akito914/Four-Leg-BLDC-Driver/quadBLDC.kicad_pcb

## KiCad design quadBLDC.kicad_pcb (2022-10-01)

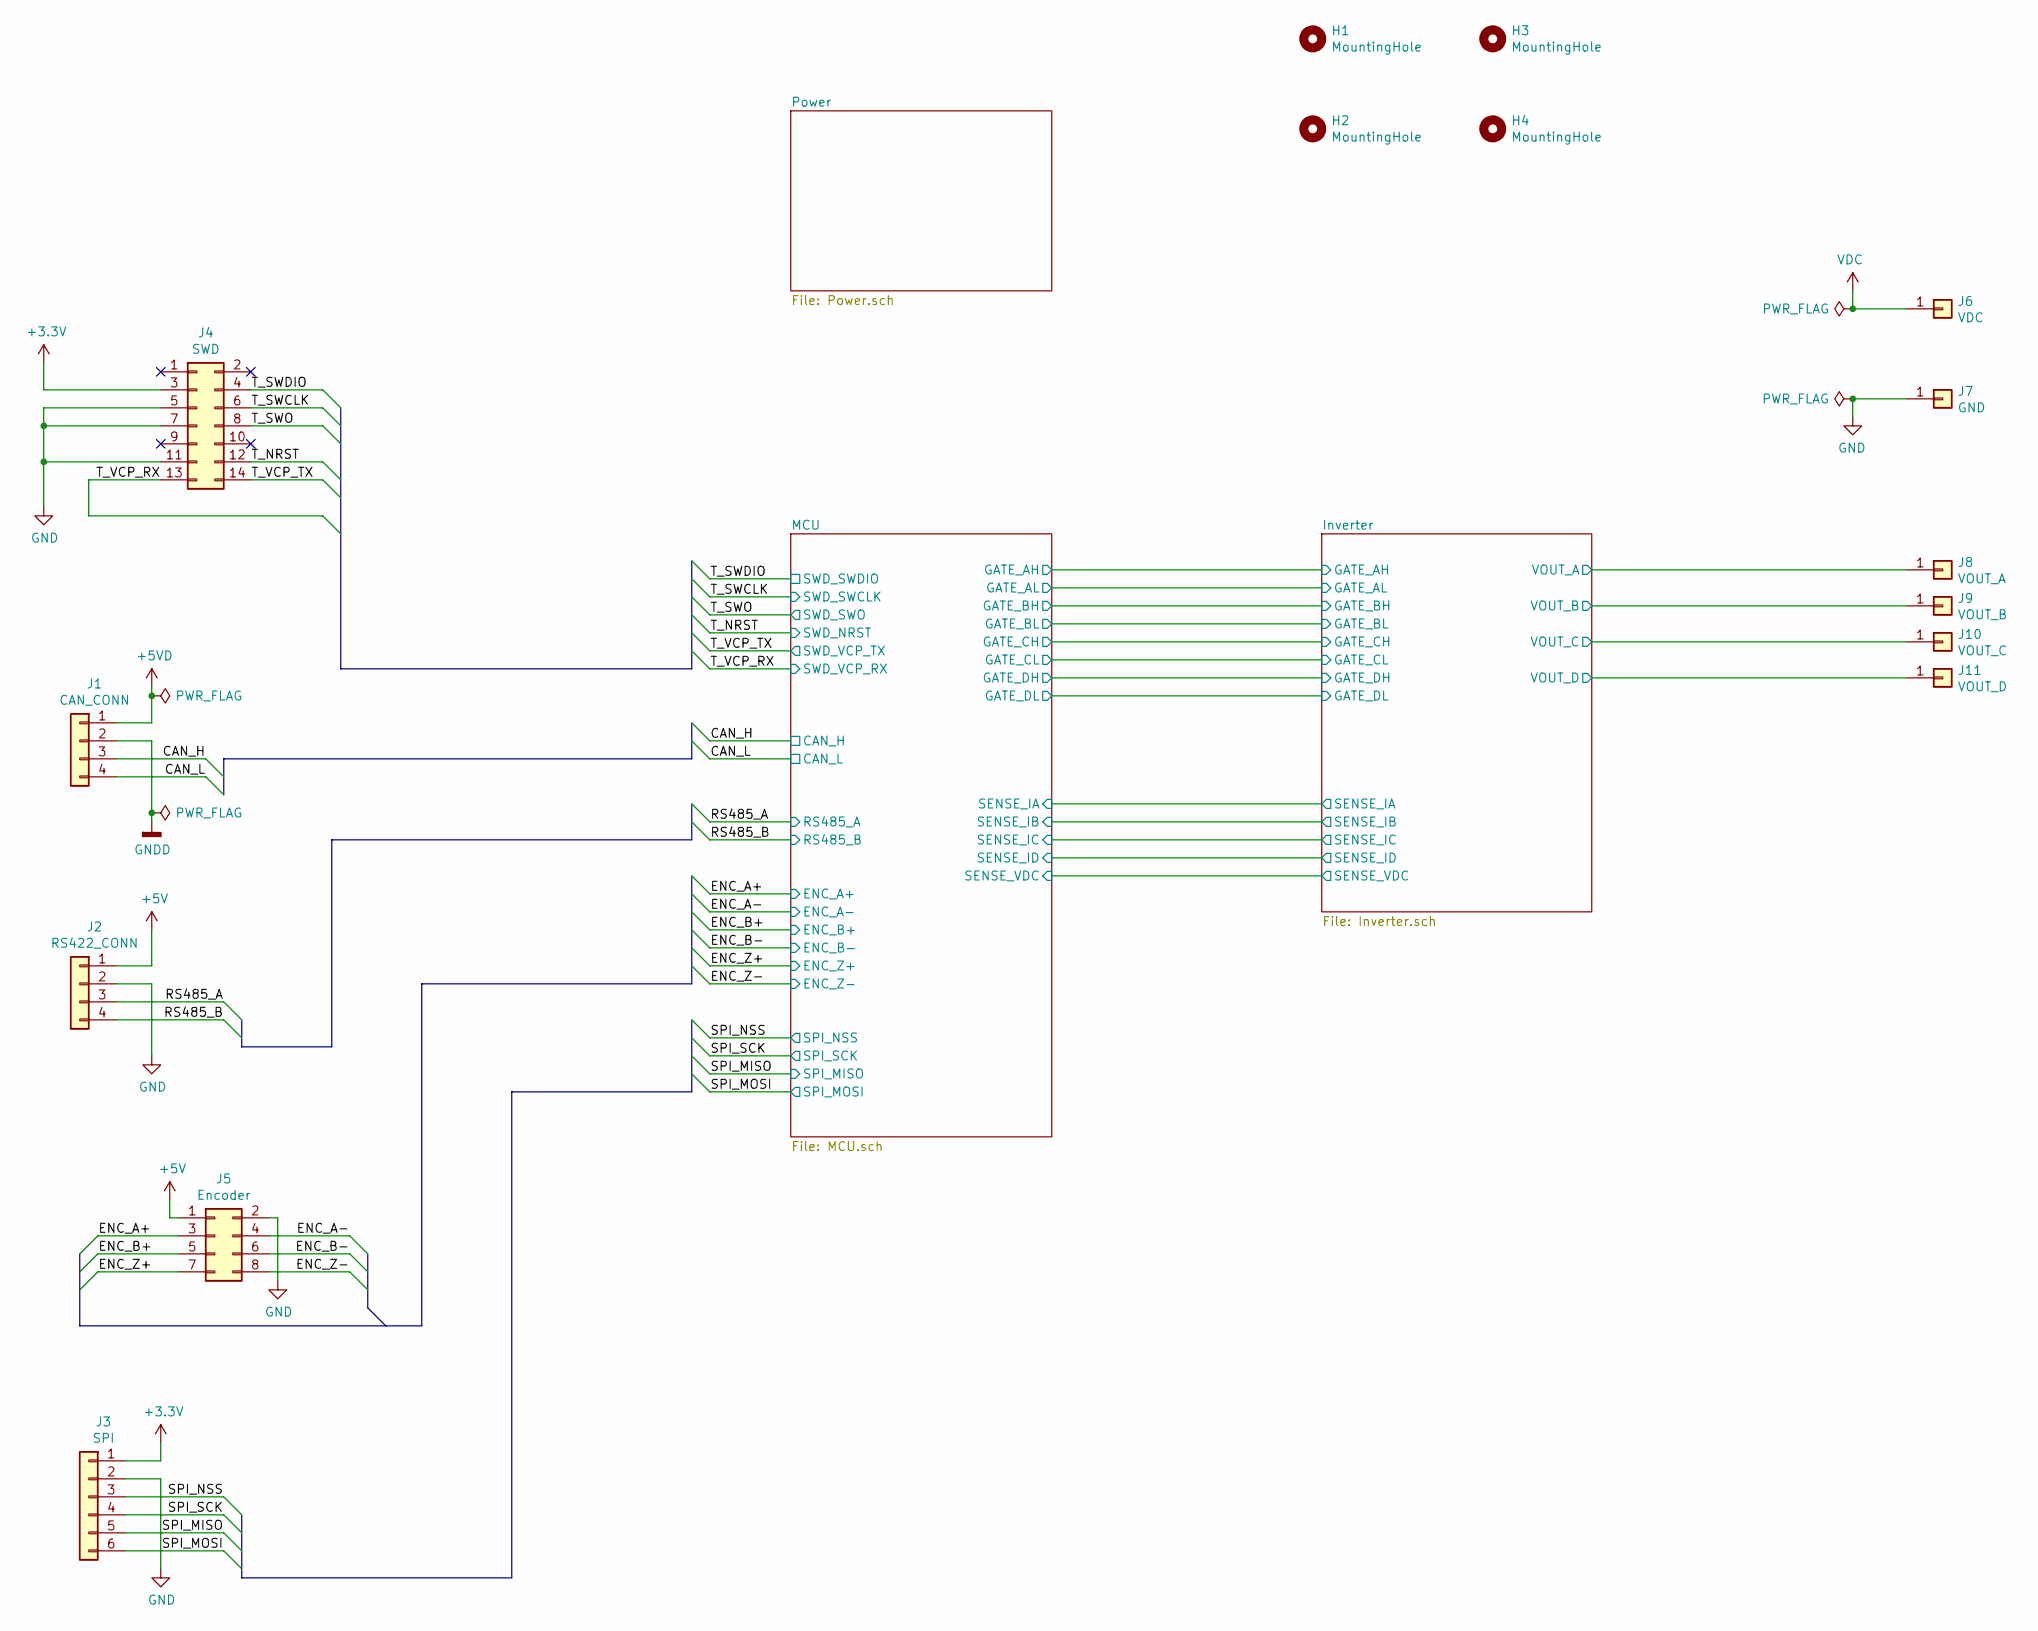
[picture p1: schematic quadBLDC.sch]

Parts:
H1, H2, H3, H4: MountingHole; MountingHole_3.2mm_M3
J1: CAN_CONN; JST_PH_B4B-PH-K_1x04_P2.00mm_Vertical
J2: RS422_CONN; JST_PH_B4B-PH-K_1x04_P2.00mm_Vertical
J3: SPI; JST_PH_B6B-PH-K_1x06_P2.00mm_Vertical
J4: SWD; PinHeader_2x07_P1.27mm_Vertical_SMD
J5: Encoder; JST_PHD_B8B-PHDSS_2x04_P2.00mm_Vertical
J6: VDC; SolderWire-2.5sqmm_1x01_D2.4mm_OD3.6mm
J7: GND; SolderWire-2.5sqmm_1x01_D2.4mm_OD3.6mm
J8: VOUT_A; SolderWire-2.5sqmm_1x01_D2.4mm_OD3.6mm
J9: VOUT_B; SolderWire-2.5sqmm_1x01_D2.4mm_OD3.6mm
J10: VOUT_C; SolderWire-2.5sqmm_1x01_D2.4mm_OD3.6mm
J11: VOUT_D; SolderWire-2.5sqmm_1x01_D2.4mm_OD3.6mm

Connections:
+3V3: J3.1, J4.3; also elsewhere on the board
+5V: J2.1, J5.1; also elsewhere on the board
+5VD: J1.1; also elsewhere on the board
/CAN_H: J1.3; also elsewhere on the board
/CAN_L: J1.4; also elsewhere on the board
/ENC_A+: J5.3; also elsewhere on the board
/ENC_A-: J5.4; also elsewhere on the board
/ENC_B+: J5.5; also elsewhere on the board
/ENC_B-: J5.6; also elsewhere on the board
/ENC_Z+: J5.7; also elsewhere on the board
/ENC_Z-: J5.8; also elsewhere on the board
/Inverter/VOUT_A: J8.1; also elsewhere on the board
/Inverter/VOUT_B: J9.1; also elsewhere on the board
/Inverter/VOUT_C: J10.1; also elsewhere on the board
/Inverter/VOUT_D: J11.1; also elsewhere on the board
/RS485_A: J2.3; also elsewhere on the board
/RS485_B: J2.4; also elsewhere on the board
/SPI_MISO: J3.5; also elsewhere on the board
/SPI_MOSI: J3.6; also elsewhere on the board
/SPI_NSS: J3.3; also elsewhere on the board
/SPI_SCK: J3.4; also elsewhere on the board
/T_NRST: J4.12; also elsewhere on the board
/T_SWCLK: J4.6; also elsewhere on the board
/T_SWDIO: J4.4; also elsewhere on the board
/T_SWO: J4.8; also elsewhere on the board
/T_VCP_RX: J4.13; also elsewhere on the board
/T_VCP_TX: J4.14; also elsewhere on the board
GND: J2.2, J3.2, J4.5, J4.7, J4.11, J5.2, J7.1; also elsewhere on the board
GNDD: J1.2; also elsewhere on the board
VDC: J6.1; also elsewhere on the board

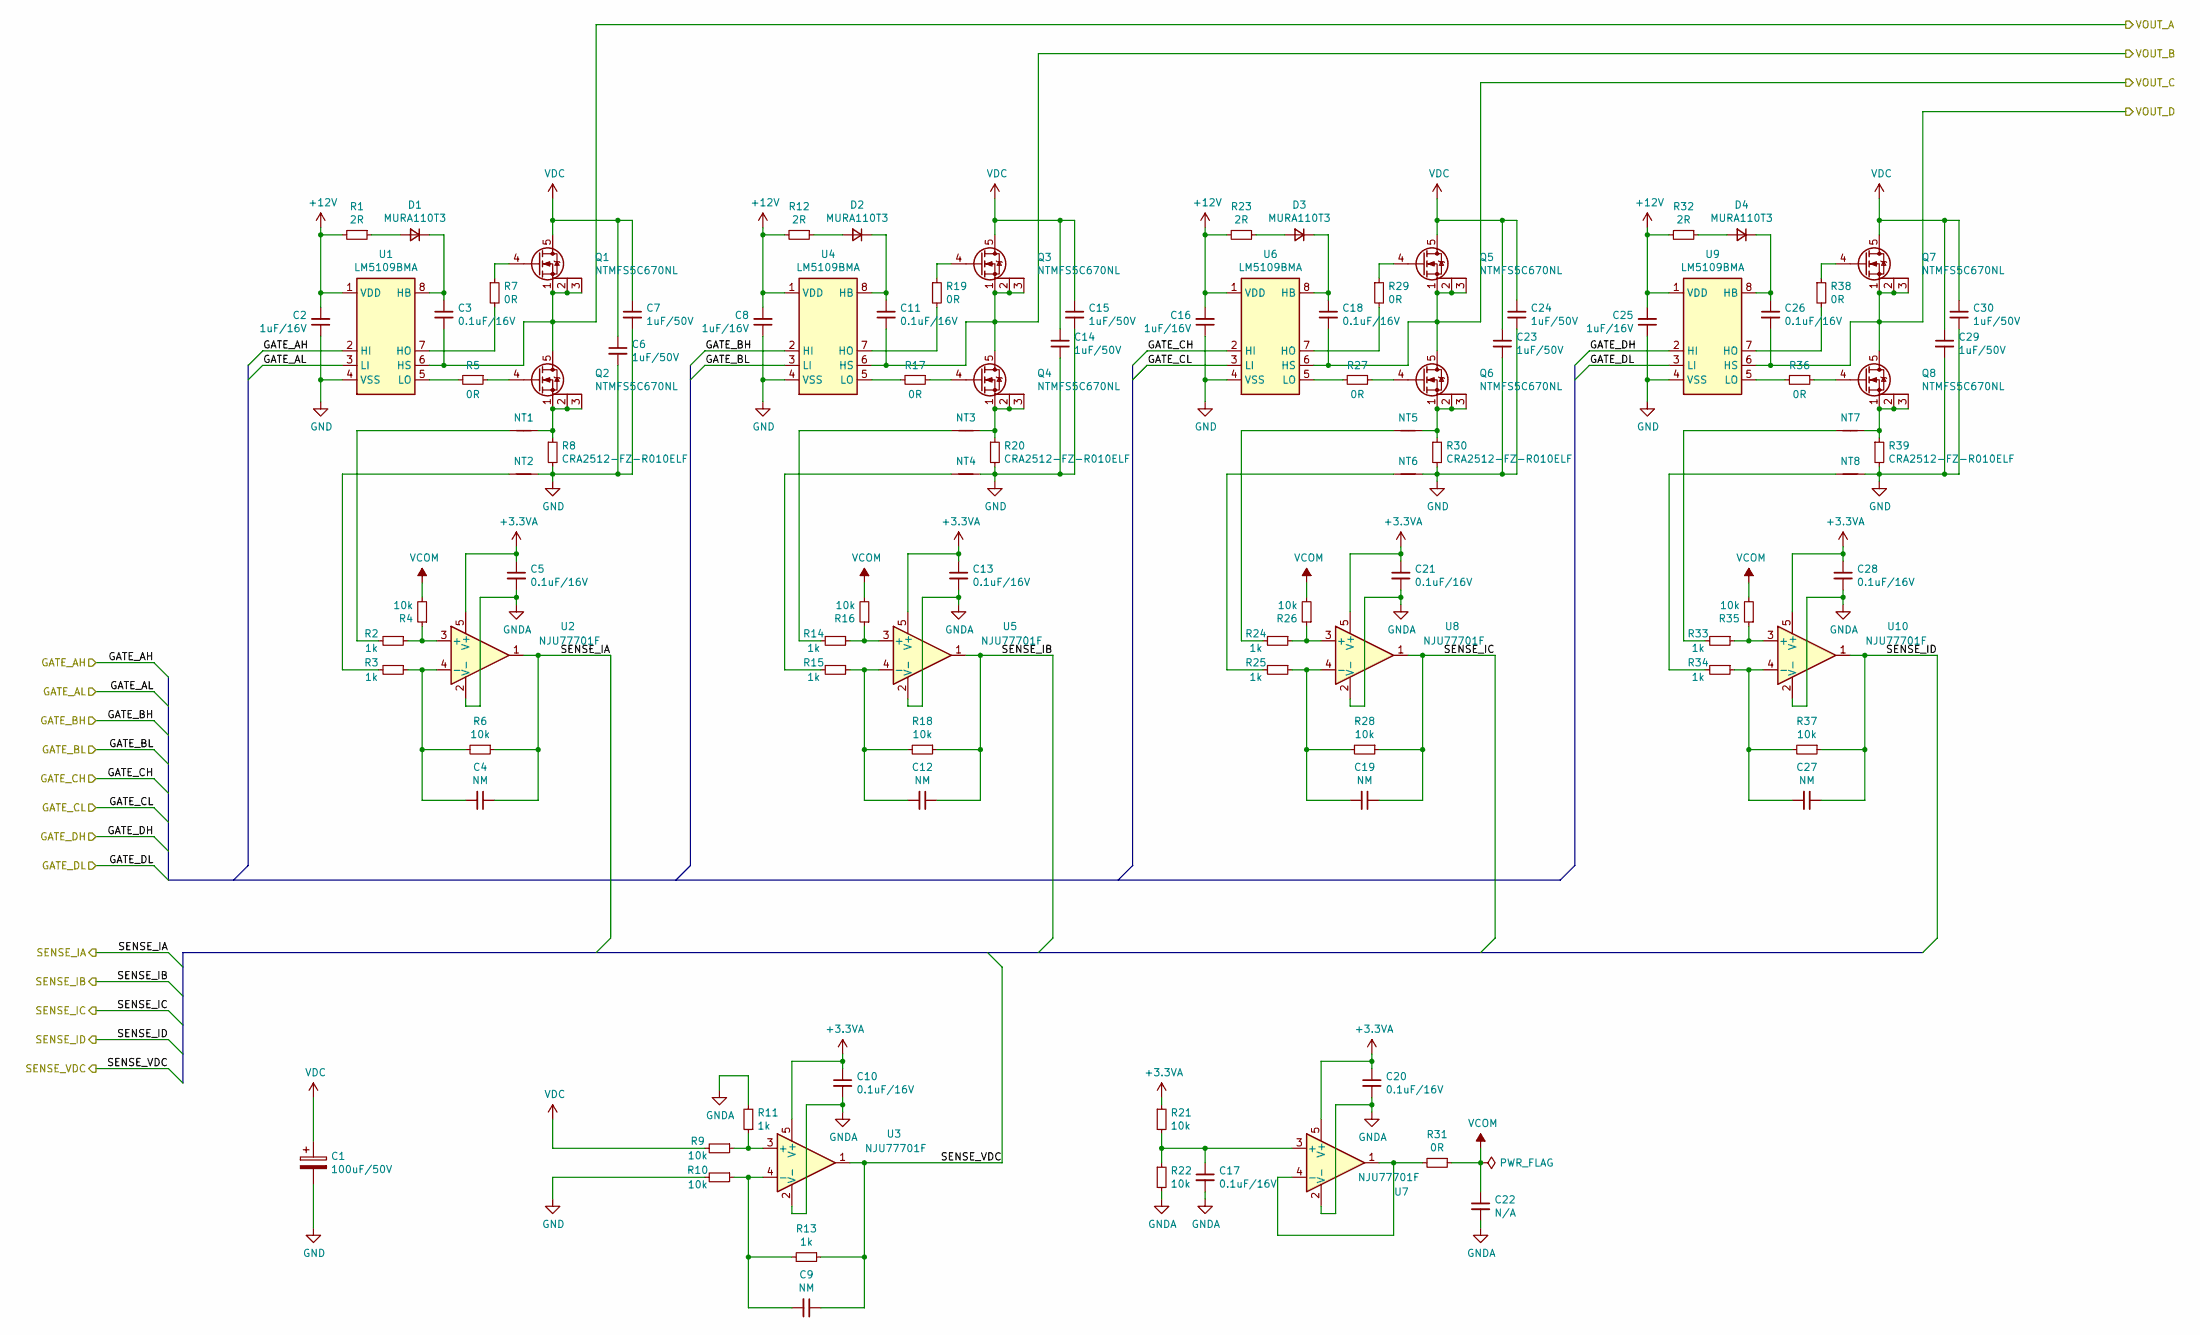
[picture p2: schematic Inverter.sch]

Parts:
C1: 100uF/50V; CP_Elec_10x10
C2, C8, C16, C25: 1uF/16V; C_0603_1608Metric
C3, C5, C10, C11, C13, C17, C18, C20, C21, C26, C28: 0.1uF/16V; C_0603_1608Metric
C4, C9, C12, C19, C27: NM; C_0603_1608Metric
C6, C7, C14, C15, C23, C24, C29, C30: 1uF/50V; C_0805_2012Metric
C22: N/A; C_0603_1608Metric
D1, D2, D3, D4: MURA110T3; D_SMA
NT1, NT2, NT3, NT4, NT5, NT6, NT7, NT8: Net-Tie_2; NetTie-2_SMD_Pad0.5mm
Q1, Q2, Q3, Q4, Q5, Q6, Q7, Q8: NTMFS5C670NL; PowerPAK_SO-8_Single
R1, R12, R23, R32: 2R; R_0603_1608Metric
R2, R3, R11, R13, R14, R15, R24, R25, R33, R34: 1k; R_0603_1608Metric
R4, R6, R9, R10, R16, R18, R21, R22, R26, R28, R35, R37: 10k; R_0603_1608Metric
R5, R7, R17, R19, R27, R29, R31, R36, R38: 0R; R_0603_1608Metric
R8, R20, R30, R39: CRA2512-FZ-R010ELF; R_2512_6332Metric
U1, U4, U6, U9: LM5109BMA; SOIC-8_3.9x4.9mm_P1.27mm
U2, U3, U5, U7, U8, U10: NJU77701F; SOT-23-5

Connections:
+3.3VA: C5.1, C10.1, C13.1, C20.1, C21.1, C28.1, R21.1, U2.5 (V+), U3.5 (V+), U5.5 (V+), U7.5 (V+), U8.5 (V+), U10.5 (V+); also elsewhere on the board
+12V: C2.2, C8.2, C16.2, C25.2, R1.2, R12.2, R23.2, R32.2, U1.1 (VDD), U4.1 (VDD), U6.1 (VDD), U9.1 (VDD); also elsewhere on the board
/Inverter/GATE_AH: U1.2 (HI); also elsewhere on the board
/Inverter/GATE_AL: U1.3 (LI); also elsewhere on the board
/Inverter/GATE_BH: U4.2 (HI); also elsewhere on the board
/Inverter/GATE_BL: U4.3 (LI); also elsewhere on the board
/Inverter/GATE_CH: U6.2 (HI); also elsewhere on the board
/Inverter/GATE_CL: U6.3 (LI); also elsewhere on the board
/Inverter/GATE_DH: U9.2 (HI); also elsewhere on the board
/Inverter/GATE_DL: U9.3 (LI); also elsewhere on the board
/Inverter/SENSE_IA: C4.1, R6.1, U2.1; also elsewhere on the board
/Inverter/SENSE_IB: C12.1, R18.1, U5.1; also elsewhere on the board
/Inverter/SENSE_IC: C19.1, R28.1, U8.1; also elsewhere on the board
/Inverter/SENSE_ID: C27.1, R37.1, U10.1; also elsewhere on the board
/Inverter/SENSE_VDC: C9.1, R13.1, U3.1; also elsewhere on the board
/Inverter/VOUT_A: C3.2, Q1.1 (S), Q1.2 (D), Q1.3 (D), Q2.5 (D), U1.6 (HS); also elsewhere on the board
/Inverter/VOUT_B: C11.2, Q3.1 (S), Q3.2 (D), Q3.3 (D), Q4.5 (D), U4.6 (HS); also elsewhere on the board
/Inverter/VOUT_C: C18.2, Q5.1 (S), Q5.2 (D), Q5.3 (D), Q6.5 (D), U6.6 (HS); also elsewhere on the board
/Inverter/VOUT_D: C26.2, Q7.1 (S), Q7.2 (D), Q7.3 (D), Q8.5 (D), U9.6 (HS); also elsewhere on the board
GND: C1.2, C2.1, C6.2, C7.2, C8.1, C14.2, C15.2, C16.1, C23.2, C24.2, C25.1, C29.2, C30.2, NT2.1, NT4.1, NT6.1, NT8.1, R8.2, R10.2, R20.2, R30.2, R39.2, U1.4 (VSS), U4.4 (VSS), U6.4 (VSS), U9.4 (VSS); also elsewhere on the board
GNDA: C5.2, C10.2, C13.2, C17.2, C20.2, C21.2, C22.2, C28.2, R11.2, R22.2, U2.2 (V-), U3.2 (V-), U5.2 (V-), U7.2 (V-), U8.2 (V-), U10.2 (V-); also elsewhere on the board
unnamed: C3.1, D1.1 (K), U1.8 (HB)
unnamed: C4.2, R3.1, R6.2, U2.4 (-)
unnamed: C9.2, R10.1, R13.2, U3.4 (-)
unnamed: C11.1, D2.1 (K), U4.8 (HB)
unnamed: C12.2, R15.1, R18.2, U5.4 (-)
unnamed: C17.1, R21.2, R22.1, U7.3 (+)
unnamed: C18.1, D3.1 (K), U6.8 (HB)
unnamed: C19.2, R25.1, R28.2, U8.4 (-)
unnamed: C26.1, D4.1 (K), U9.8 (HB)
unnamed: C27.2, R34.1, R37.2, U10.4 (-)
unnamed: D1.2 (A), R1.1
unnamed: D2.2 (A), R12.1
unnamed: D3.2 (A), R23.1
unnamed: D4.2 (A), R32.1
unnamed: NT1.1, Q2.1 (S), Q2.2 (D), Q2.3 (D), R8.1
unnamed: NT1.2, R2.2
unnamed: NT2.2, R3.2
unnamed: NT3.1, Q4.1 (S), Q4.2 (D), Q4.3 (D), R20.1
unnamed: NT3.2, R14.2
unnamed: NT4.2, R15.2
unnamed: NT5.1, Q6.1 (S), Q6.2 (D), Q6.3 (D), R30.1
unnamed: NT5.2, R24.2
unnamed: NT6.2, R25.2
unnamed: NT7.1, Q8.1 (S), Q8.2 (D), Q8.3 (D), R39.1
unnamed: NT7.2, R33.2
unnamed: NT8.2, R34.2
unnamed: Q1.4 (G), R7.1
unnamed: Q2.4 (G), R5.1
unnamed: Q3.4 (G), R19.1
unnamed: Q4.4 (G), R17.1
unnamed: Q5.4 (G), R29.1
unnamed: Q6.4 (G), R27.1
unnamed: Q7.4 (G), R38.1
unnamed: Q8.4 (G), R36.1
unnamed: R2.1, R4.1, U2.3 (+)
unnamed: R5.2, U1.5 (LO)
unnamed: R7.2, U1.7 (HO)
unnamed: R9.1, R11.1, U3.3 (+)
unnamed: R14.1, R16.1, U5.3 (+)
unnamed: R17.2, U4.5 (LO)
unnamed: R19.2, U4.7 (HO)
unnamed: R24.1, R26.1, U8.3 (+)
unnamed: R27.2, U6.5 (LO)
unnamed: R29.2, U6.7 (HO)
unnamed: R31.2, U7.1, U7.4 (-)
unnamed: R33.1, R35.1, U10.3 (+)
unnamed: R36.2, U9.5 (LO)
unnamed: R38.2, U9.7 (HO)
VCOM: C22.1, R4.2, R16.2, R26.2, R31.1, R35.2
VDC: C1.1, C6.1, C7.1, C14.1, C15.1, C23.1, C24.1, C29.1, C30.1, Q1.5 (D), Q3.5 (D), Q5.5 (D), Q7.5 (D), R9.2; also elsewhere on the board

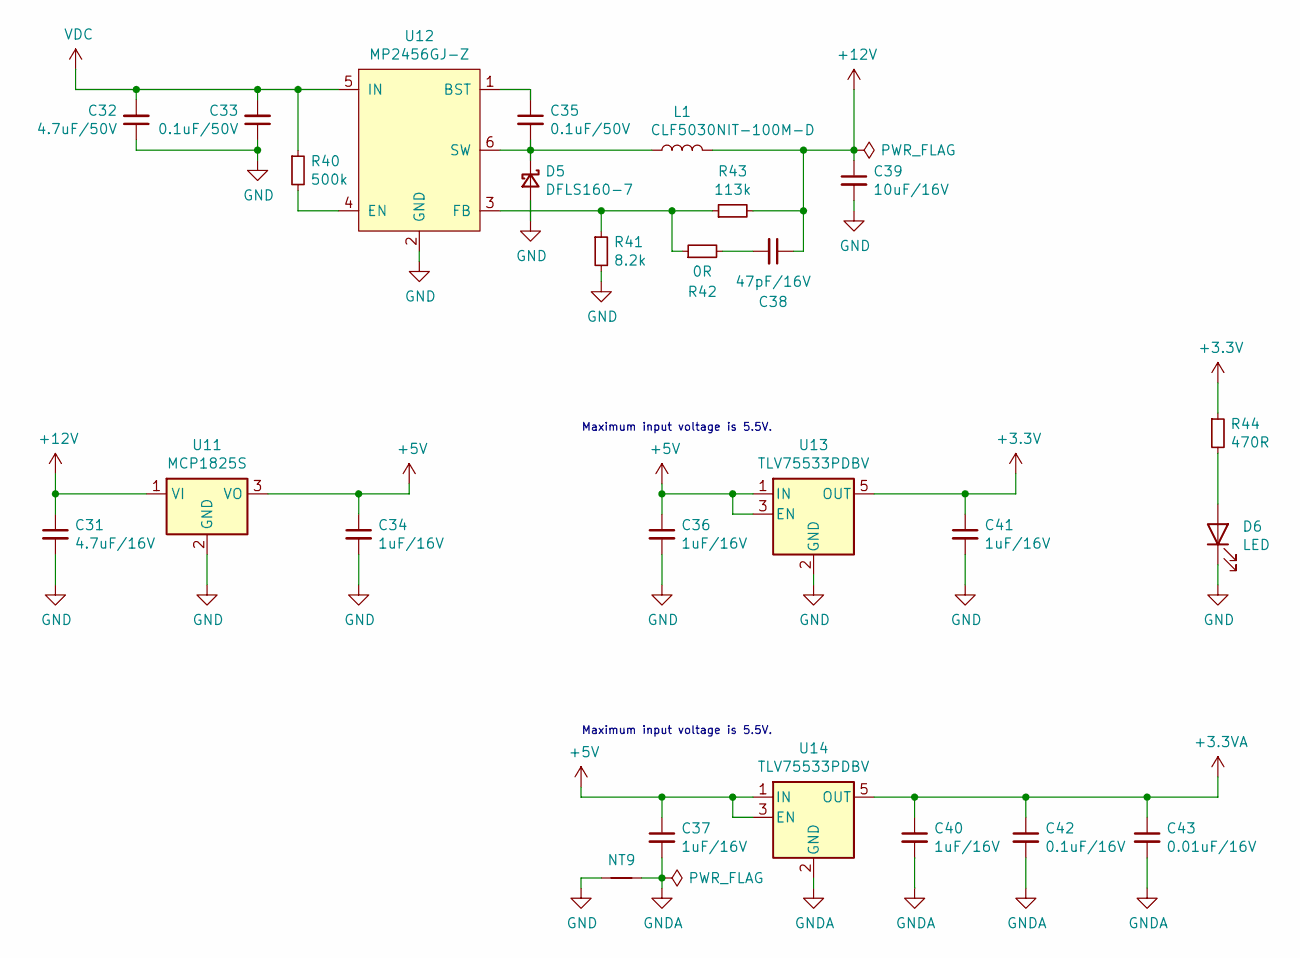
[picture p3: schematic Power.sch]

Parts:
C31: 4.7uF/16V; C_0805_2012Metric
C32: 4.7uF/50V; C_0805_2012Metric
C33, C35: 0.1uF/50V; C_0603_1608Metric
C34, C36, C37, C40, C41: 1uF/16V; C_0603_1608Metric
C38: 47pF/16V; C_0603_1608Metric
C39: 10uF/16V; C_0805_2012Metric
C42: 0.1uF/16V; C_0603_1608Metric
C43: 0.01uF/16V; C_0603_1608Metric
D5: DFLS160-7; D_PowerDI-123
D6: LED; LED_0603_1608Metric
L1: CLF5030NIT-100M-D; L_TDK_CLF5030NI-D
NT9: Net-Tie_2; NetTie-2_SMD_Pad0.5mm
R40: 500k; R_0603_1608Metric
R41: 8.2k; R_0603_1608Metric
R42: 0R; R_0603_1608Metric
R43: 113k; R_0603_1608Metric
R44: 470R; R_0603_1608Metric
U11: MCP1825S; SOT-223-3_TabPin2
U12: MP2456GJ-Z; SOT-23-6
U13, U14: TLV75533PDBV; SOT-23-5

Connections:
+3.3VA: C40.1, C42.1, C43.1, U14.5 (OUT); also elsewhere on the board
+3V3: C41.1, R44.1, U13.5 (OUT); also elsewhere on the board
+5V: C34.1, C36.1, C37.1, U11.3 (VO), U13.1 (IN), U13.3 (EN), U14.1 (IN), U14.3 (EN); also elsewhere on the board
+12V: C31.1, C38.1, C39.1, L1.2, R43.2, U11.1 (VI); also elsewhere on the board
GND: C31.2, C32.1, C33.1, C34.2, C36.2, C39.2, C41.2, D5.2 (A), D6.1 (K), NT9.2, R41.2, U11.2 (GND), U12.2 (GND), U13.2 (GND); also elsewhere on the board
GNDA: C37.2, C40.2, C42.2, C43.2, NT9.1, U14.2 (GND); also elsewhere on the board
unnamed: C35.1, U12.1 (BST)
unnamed: C35.2, D5.1 (K), L1.1, U12.6 (SW)
unnamed: C38.2, R42.2
unnamed: D6.2 (A), R44.2
unnamed: R40.2, U12.4 (EN)
unnamed: R41.1, R42.1, R43.1, U12.3 (FB)
VDC: C32.2, C33.2, R40.1, U12.5 (IN); also elsewhere on the board

Notes on the sheet:
Maximum input voltage is 5.5V.

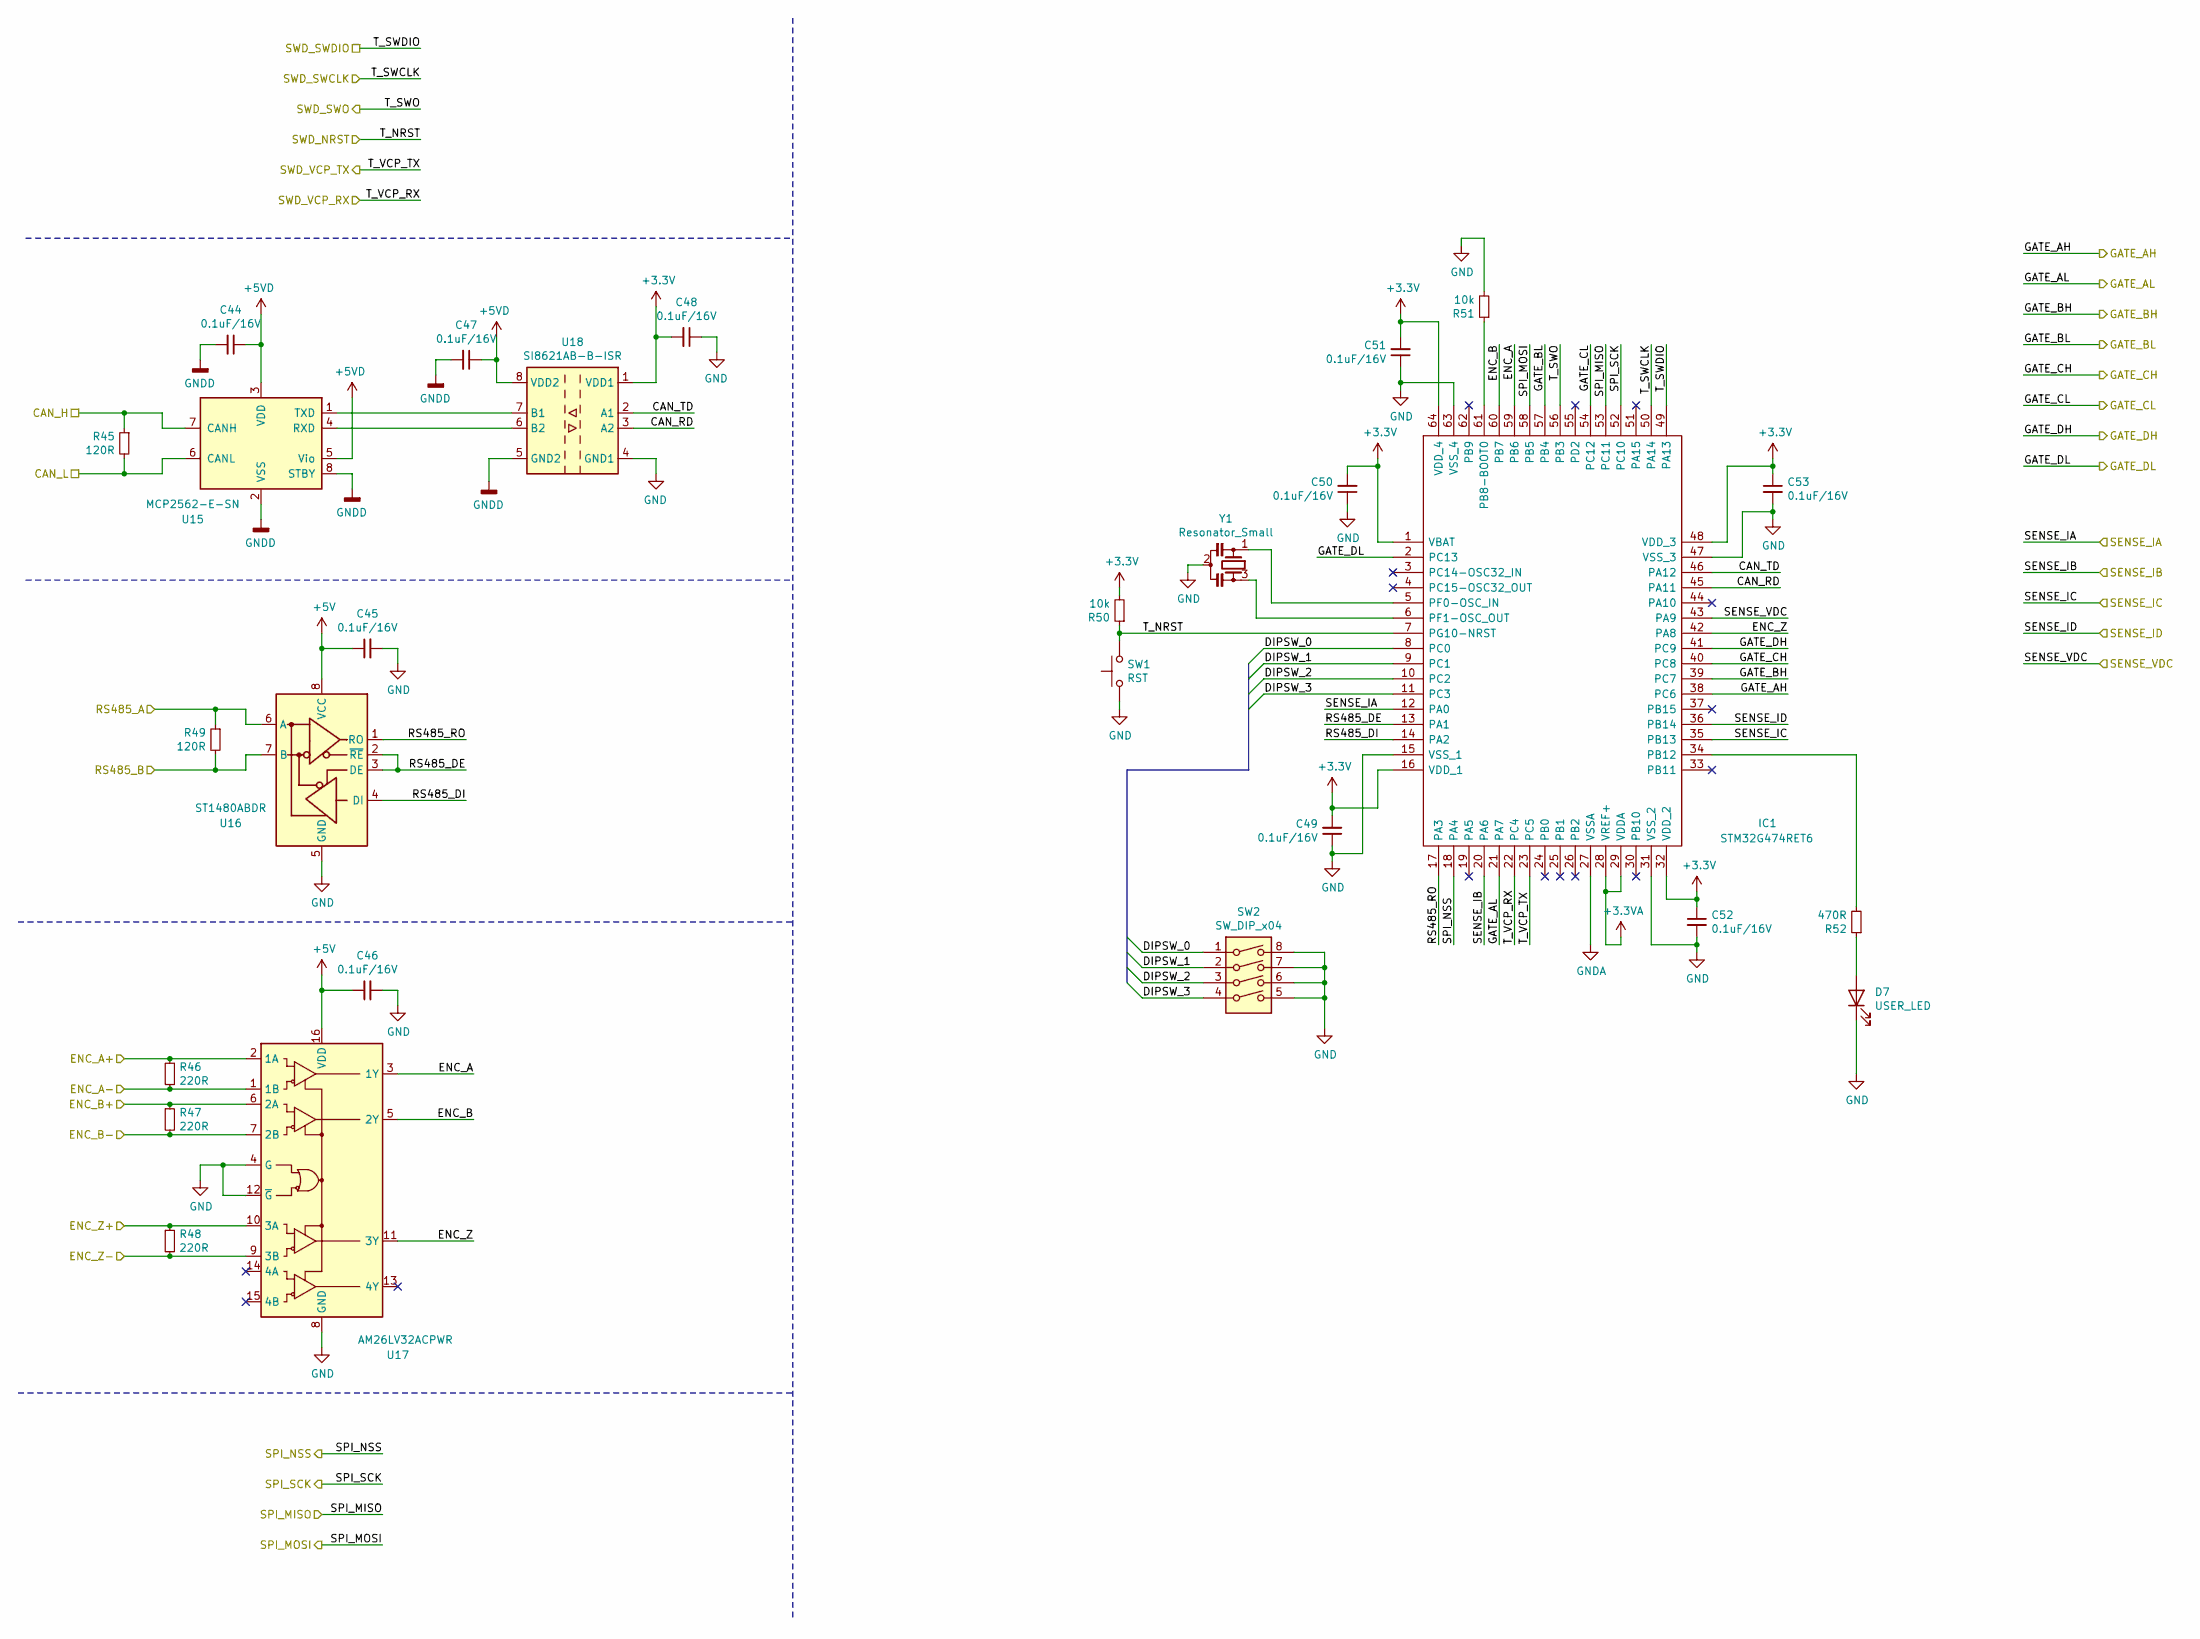
[picture p4: schematic MCU.sch]

Parts:
C44, C45, C46, C47, C48, C49, C50, C51, C52, C53: 0.1uF/16V; C_0603_1608Metric
D7: USER_LED; LED_0603_1608Metric
IC1: STM32G474RET6; QFP50P1200X1200X160-64N
R45, R49: 120R; R_0603_1608Metric
R46, R47, R48: 220R; R_0603_1608Metric
R50, R51: 10k; R_0603_1608Metric
R52: 470R; R_0603_1608Metric
SW1: RST; SKRPACE010
SW2: SW_DIP_x04; SOIC127P812X230-8N
U15: MCP2562-E-SN; SOIC-8_3.9x4.9mm_P1.27mm
U16: ST1480ABDR; SOIC-8_3.9x4.9mm_P1.27mm
U17: AM26LV32ACPWR; TSSOP-16_4.4x5mm_P0.65mm
U18: SI8621AB-B-ISR; SOIC-8_3.9x4.9mm_P1.27mm
Y1: Resonator_Small; Resonator_SMD_muRata_CSTxExxV-3Pin_3.0x1.1mm

Connections:
+3.3VA: IC1.28 (VREF+), IC1.29 (VDDA); also elsewhere on the board
+3V3: C48.2, C49.2, C50.2, C51.2, C52.1, C53.1, IC1.1 (VBAT), IC1.16 (VDD_1), IC1.32 (VDD_2), IC1.48 (VDD_3), IC1.64 (VDD_4), R50.2, U18.1 (VDD1); also elsewhere on the board
+5V: C45.1, C46.1, U16.8 (VCC), U17.16 (VDD); also elsewhere on the board
+5VD: C44.1, C47.1, U15.3 (VDD), U15.5 (Vio), U18.8 (VDD2); also elsewhere on the board
/CAN_H: R45.1, U15.7 (CANH); also elsewhere on the board
/CAN_L: R45.2, U15.6 (CANL); also elsewhere on the board
/ENC_A+: R46.1, U17.2 (1A); also elsewhere on the board
/ENC_A-: R46.2, U17.1 (1B); also elsewhere on the board
/ENC_B+: R47.1, U17.6 (2A); also elsewhere on the board
/ENC_B-: R47.2, U17.7 (2B); also elsewhere on the board
/ENC_Z+: R48.1, U17.10 (3A); also elsewhere on the board
/ENC_Z-: R48.2, U17.9 (3B); also elsewhere on the board
/Inverter/GATE_AH: IC1.38 (PC6); also elsewhere on the board
/Inverter/GATE_AL: IC1.21 (PA7); also elsewhere on the board
/Inverter/GATE_BH: IC1.39 (PC7); also elsewhere on the board
/Inverter/GATE_BL: IC1.57 (PB4); also elsewhere on the board
/Inverter/GATE_CH: IC1.40 (PC8); also elsewhere on the board
/Inverter/GATE_CL: IC1.54 (PC12); also elsewhere on the board
/Inverter/GATE_DH: IC1.41 (PC9); also elsewhere on the board
/Inverter/GATE_DL: IC1.2 (PC13); also elsewhere on the board
/Inverter/SENSE_IA: IC1.12 (PA0); also elsewhere on the board
/Inverter/SENSE_IB: IC1.20 (PA6); also elsewhere on the board
/Inverter/SENSE_IC: IC1.35 (PB13); also elsewhere on the board
/Inverter/SENSE_ID: IC1.36 (PB14); also elsewhere on the board
/Inverter/SENSE_VDC: IC1.43 (PA9); also elsewhere on the board
/MCU/CAN_RD: IC1.45 (PA11), U18.3 (A2)
/MCU/CAN_TD: IC1.46 (PA12), U18.2 (A1)
/MCU/DIPSW_0: IC1.8 (PC0), SW2.1
/MCU/DIPSW_1: IC1.9 (PC1), SW2.2
/MCU/DIPSW_2: IC1.10 (PC2), SW2.3
/MCU/DIPSW_3: IC1.11 (PC3), SW2.4
/MCU/ENC_A: IC1.59 (PB6), U17.3 (1Y)
/MCU/ENC_B: IC1.60 (PB7), U17.5 (2Y)
/MCU/ENC_Z: IC1.42 (PA8), U17.11 (3Y)
/MCU/RS485_DE: IC1.13 (PA1), U16.2 (~RE), U16.3 (DE)
/MCU/RS485_DI: IC1.14 (PA2), U16.4 (DI)
/MCU/RS485_RO: IC1.17 (PA3), U16.1 (RO)
/RS485_A: R49.1, U16.6 (A); also elsewhere on the board
/RS485_B: R49.2, U16.7 (B); also elsewhere on the board
/SPI_MISO: IC1.53 (PC11); also elsewhere on the board
/SPI_MOSI: IC1.58 (PB5); also elsewhere on the board
/SPI_NSS: IC1.18 (PA4); also elsewhere on the board
/SPI_SCK: IC1.52 (PC10); also elsewhere on the board
/T_NRST: IC1.7 (PG10-NRST), R50.1, SW1.2; also elsewhere on the board
/T_SWCLK: IC1.50 (PA14); also elsewhere on the board
/T_SWDIO: IC1.49 (PA13); also elsewhere on the board
/T_SWO: IC1.56 (PB3); also elsewhere on the board
/T_VCP_RX: IC1.22 (PC4); also elsewhere on the board
/T_VCP_TX: IC1.23 (PC5); also elsewhere on the board
GND: C45.2, C46.2, C48.1, C49.1, C50.1, C51.1, C52.2, C53.2, D7.1 (K), IC1.15 (VSS_1), IC1.31 (VSS_2), IC1.47 (VSS_3), IC1.63 (VSS_4), R51.2, SW1.1, SW2.5, SW2.6, SW2.7, SW2.8, U16.5 (GND), U17.4 (G), U17.8 (GND), U17.12 (~G), U18.4 (GND1), Y1.2; also elsewhere on the board
GNDA: IC1.27 (VSSA); also elsewhere on the board
GNDD: C44.2, C47.2, U15.2 (VSS), U15.8 (STBY), U18.5 (GND2); also elsewhere on the board
unnamed: D7.2 (A), R52.1
unnamed: IC1.5 (PF0-OSC_IN), Y1.1
unnamed: IC1.6 (PF1-OSC_OUT), Y1.3
unnamed: IC1.34 (PB12), R52.2
unnamed: IC1.61 (PB8-BOOT0), R51.1
unnamed: U15.1 (TXD), U18.7 (B1)
unnamed: U15.4 (RXD), U18.6 (B2)

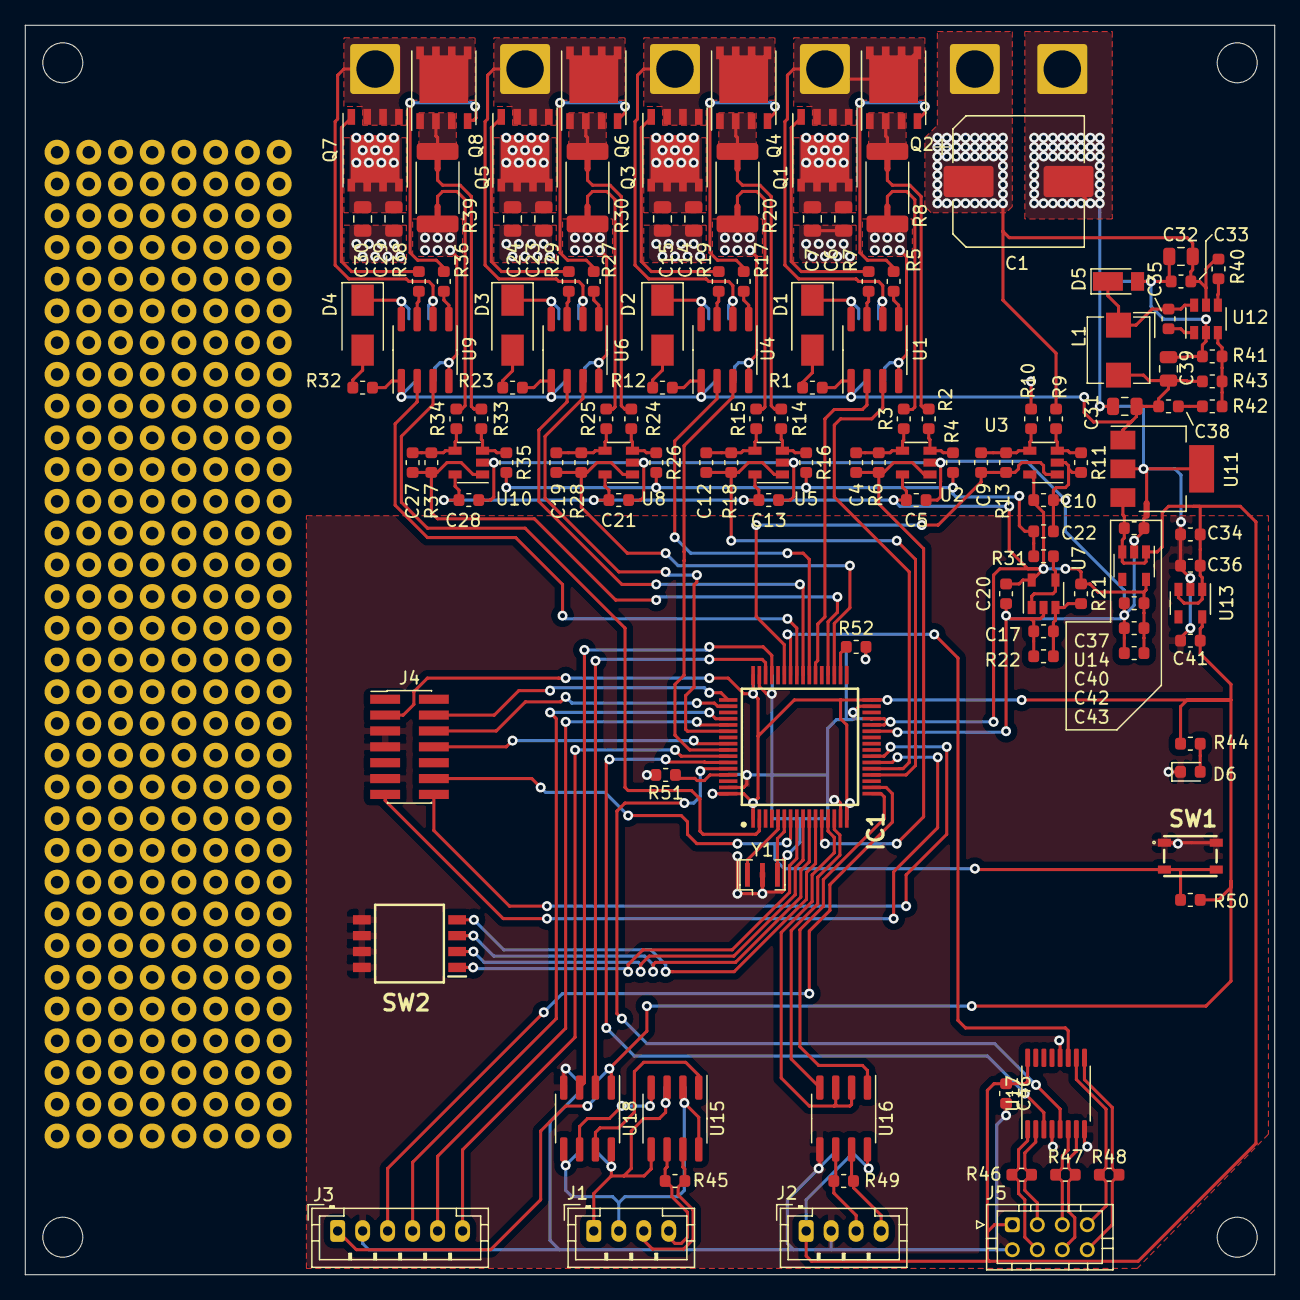
[picture p5: board quadBLDC.kicad_pcb from above]

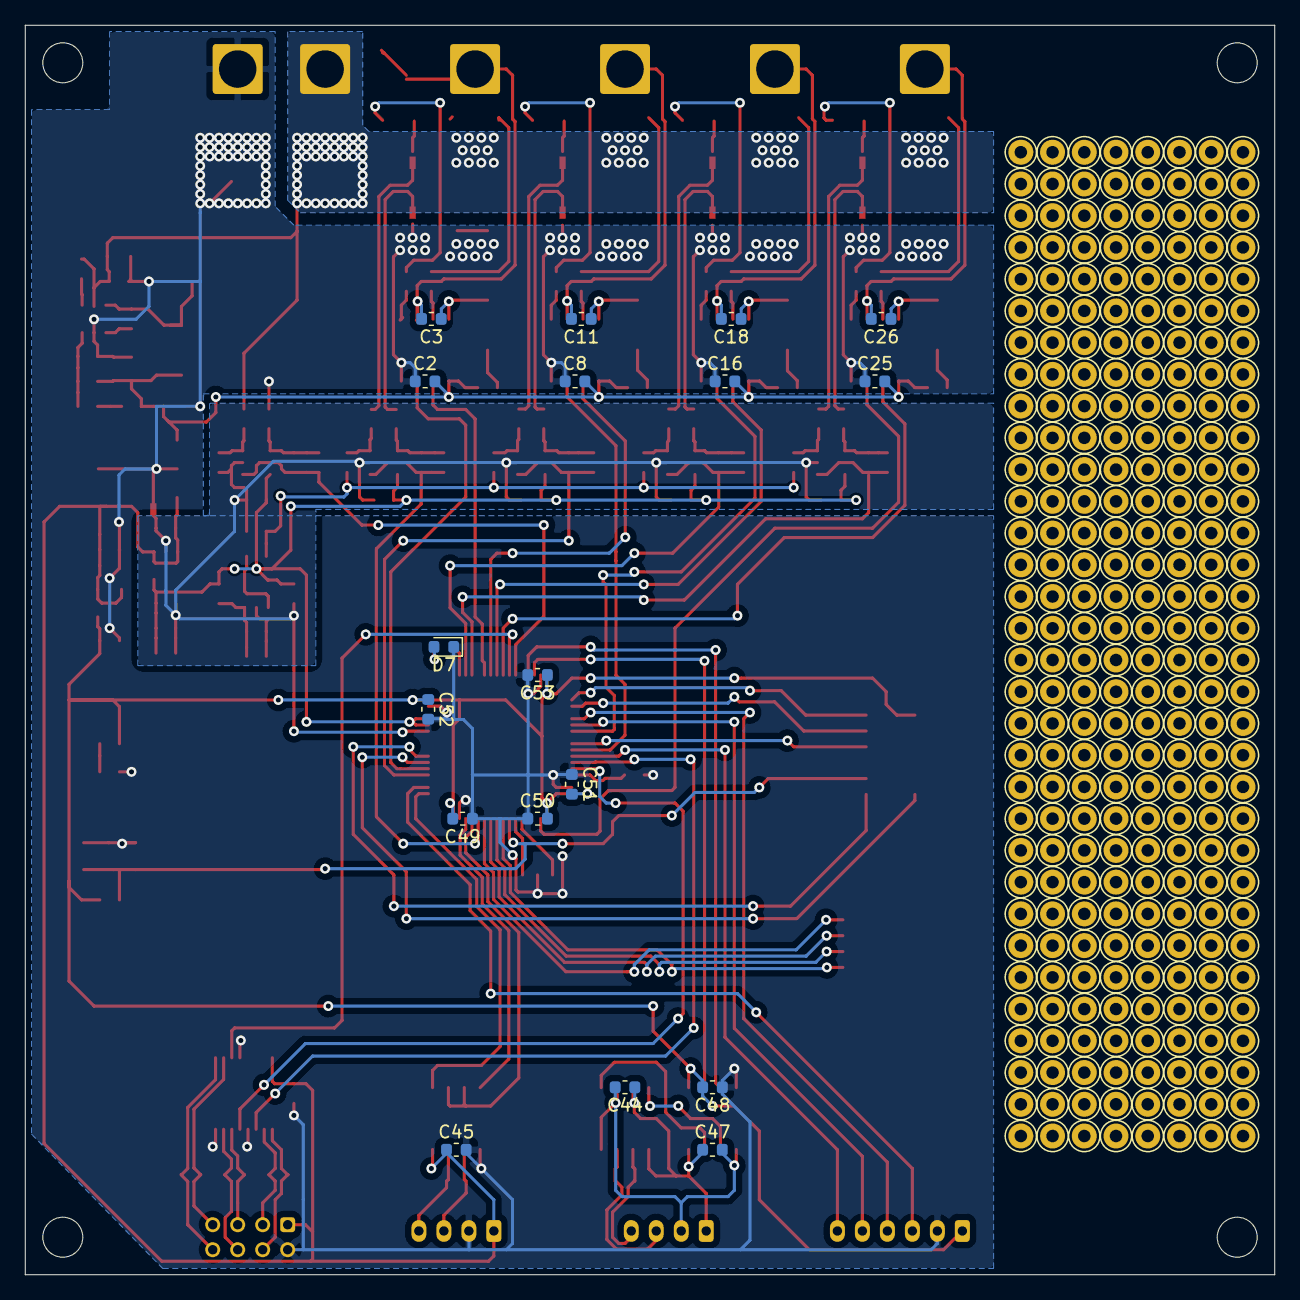
[picture p6: board quadBLDC.kicad_pcb from below]

Board: 2 copper layers, 100.0 x 100.0 mm, 167 parts (18 on the bottom side), 120 nets.
