akito914/Four-Leg-BLDC-Driver/(commit log)

2021-03-21 Update: 回路図完成
    [Inverter.sch, MCU.sch, Power.sch, quadBLDC.kicad_pcb, quadBLDC.sch]
2021-03-21 wip: レグの配置途中
    [quadBLDC.kicad_pcb]
2021-03-22 Fix: ゲートドライブの配線修正
    [Inverter.sch, quadBLDC.sch]
2021-03-22 Update: レグのデカップリングキャパシタ位置変更
    [Inverter.sch]
2021-03-22 wip: レグ配置中
    [quadBLDC.kicad_pcb]
2021-03-24 wip: レグ配線中
    [Inverter.sch, quadBLDC.kicad_pcb]
2021-03-25 wip: 配置
    [quadBLDC.kicad_pcb]
2021-04-09 Update: 回路図、DCリンクCap1つ削除、アノテーションリセット
    [Inverter.sch, MCU.sch, Power.sch, quadBLDC.sch]
2021-04-09 Update: アナログリファレンスをLDOからに変更
    [Inverter.sch, MCU.sch, Power.sch, quadBLDC.kicad_pcb]
2021-05-23 wip CAN STBYピン修正
    [MCU.sch, quadBLDC.kicad_pcb]
2021-05-23 Update : 配線一段落
    [quadBLDC.kicad_pcb]
2022-09-09 Update: シルク配置
    [quadBLDC.kicad_pcb]
2022-10-01 Add: ガーバー書き出し
    [quadBLDC.kicad_pcb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]
